DIVYA05GAVANE/3D_TFT/pdk/tft3d_platform/libs.ref/tft3d_macros/sim/FeTFT HSPICE/FeTFT_Netlist_IdVg_Polarity0.docx

Netlist: Polarity state = 0

DC sweep from -5V to +5V

* Generated for: HSPICE

* Generated on: Jul 3 17:10:52 2026

* Design library name: CAM_Circuits

* Design cell name: fetft_IdVg

* Design view name: schematic

.include '/apps/PDK/NCSU/FreePDK/FreePDK45/1.4/ncsu_basekit/models/hspice/hspice_nom.include'

* Library name: CAM_Circuits

* Cell name: fetft_IdVg

* View name: schematic

xi0 vg vd 0 fetft_nf1 pinit=0 vw=4

v1 vd 0 dc='Vd'

v2 vg 0 dc='Vg'

.param

+ Vg=0

+ Vd=100e-3

.temp 27.0

.option GEN_CUR_POL=ON

.option ARTIST=2 PSF=2 WARN_SEP=1

.option VECBUS=1 LIS_NEW=1 CONVERGE=100

.tran 100e-9 230e-6 start=0.0

.dc Vg -5.0 5.0 10e-3

.option hier_delim=1

.probe dc v(vg)

+ i(xi0.d)

.probe tran v(vg)

+ i(xi0.d)

.hdl "/users/grad/divyagavane/CAM_Circuits//fetft_nf1/veriloga/veriloga.va"

.end
