DIVYA05GAVANE/3D_TFT/3d_thermal_stress_sim/plots/stack_limit_summary.png

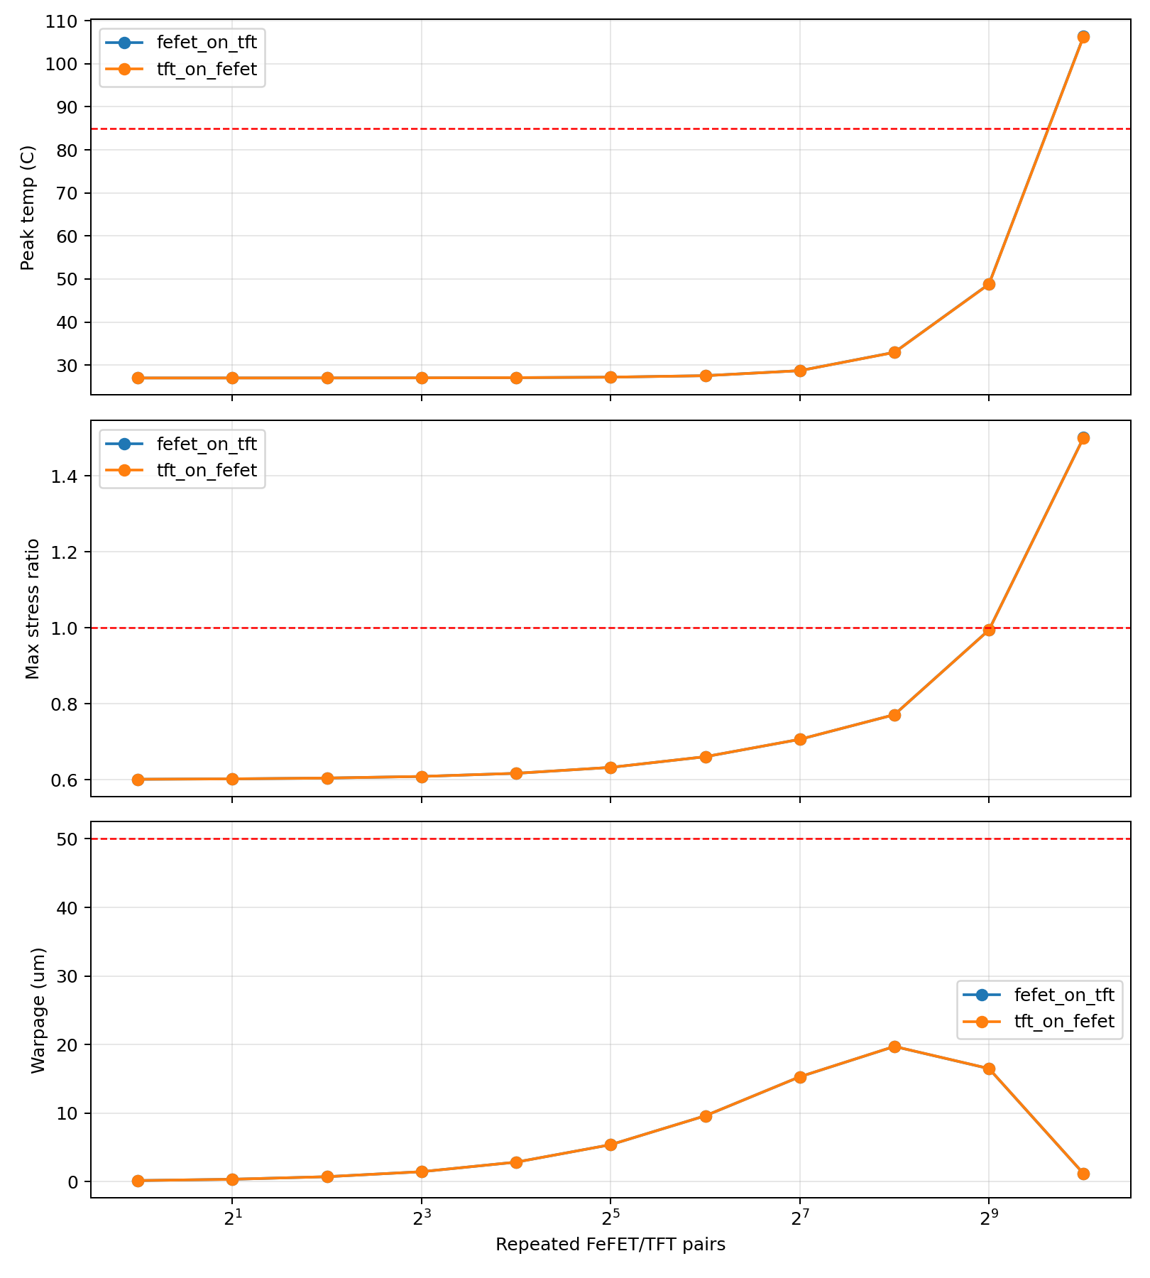
3d_thermal_stress_sim/plots/stack_limit_summary.png
