DIVYA05GAVANE/3D_TFT/pdk/tft3d_platform/libs.ref/tft3d_macros/sim/NG_spice_TFT/id_vds_tft_n1_ngspice.png

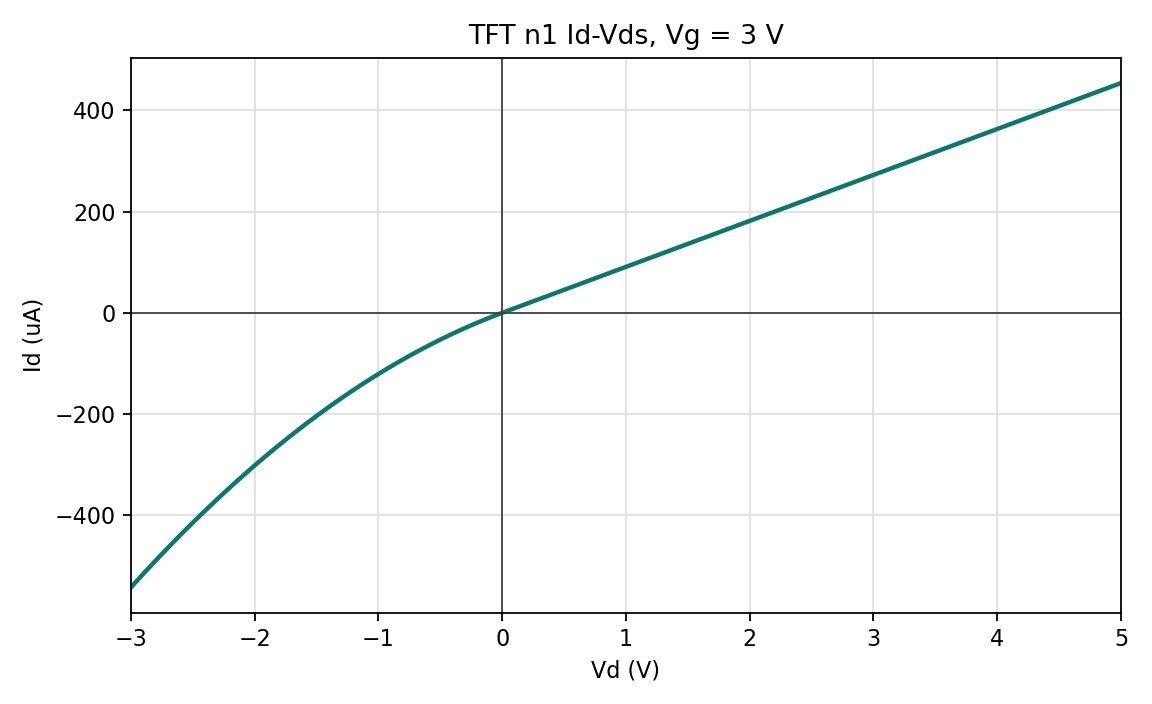
pdk/tft3d_platform/libs.ref/tft3d_macros/sim/NG_spice_TFT/id_vds_tft_n1_ngspice.png
