DIVYA05GAVANE/3D_TFT/tmp/pdfs/VLSI2026_01_20_v1_page_3.png

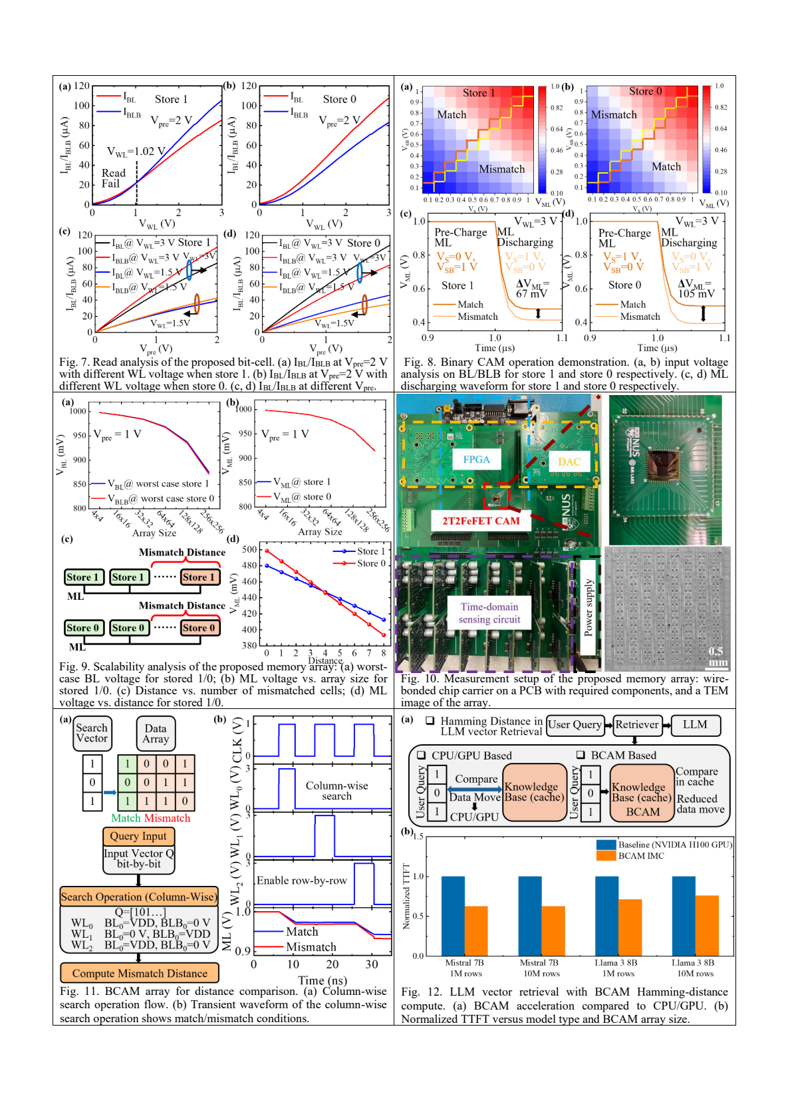
tmp/pdfs/VLSI2026_01_20_v1_page_3.png
