DIVYA05GAVANE/3D_TFT/pdk/tft3d_platform/libs.ref/tft3d_macros/sim/FeTFT HSPICE/FeTFT_IdVg_Curve.pdf

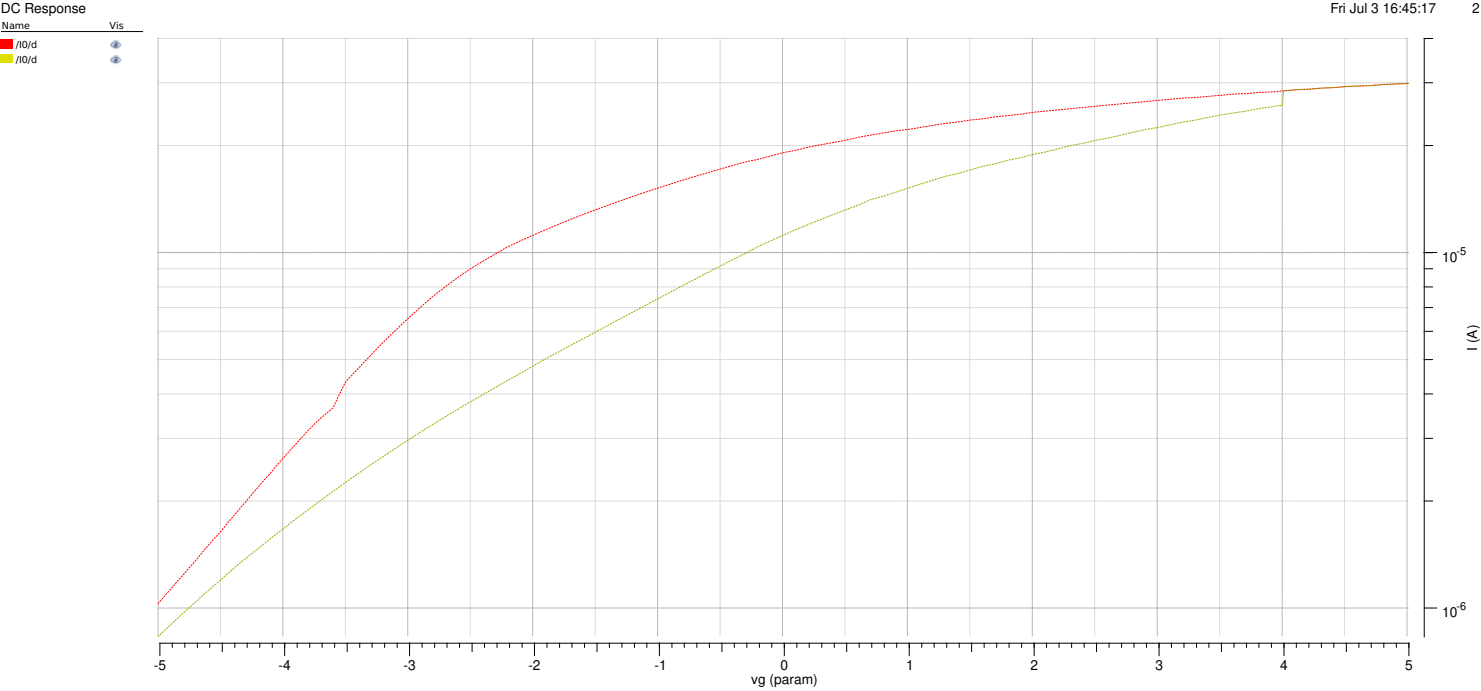
[picture p11: page 1]
Name; Vis; vg (param); DC Response; Fri Jul 3 16:45:17
