DIVYA05GAVANE/3D_TFT/pdk/tft3d_platform/libs.ref/tft3d_macros/sim/TFT HSPICE/Veriloga_gds_mapping.pdf

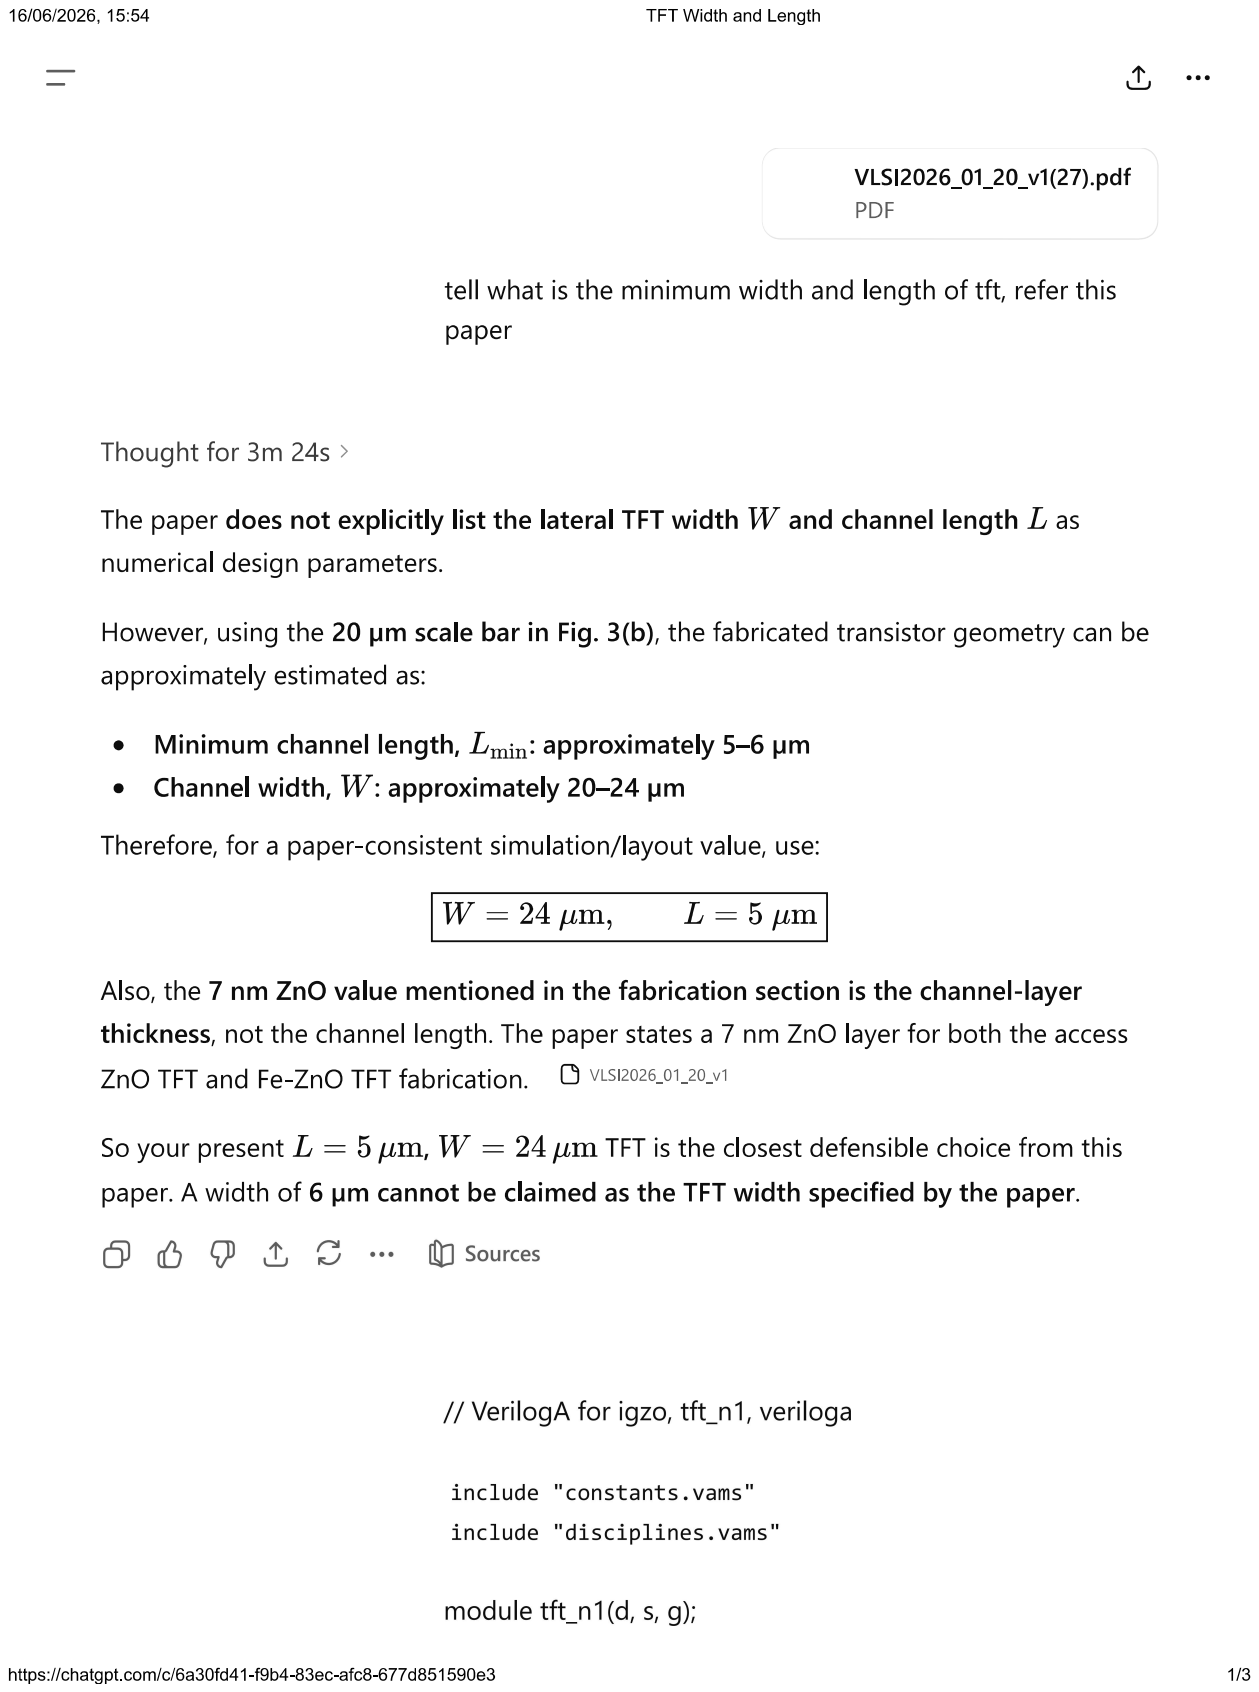
[picture p12: page 1]

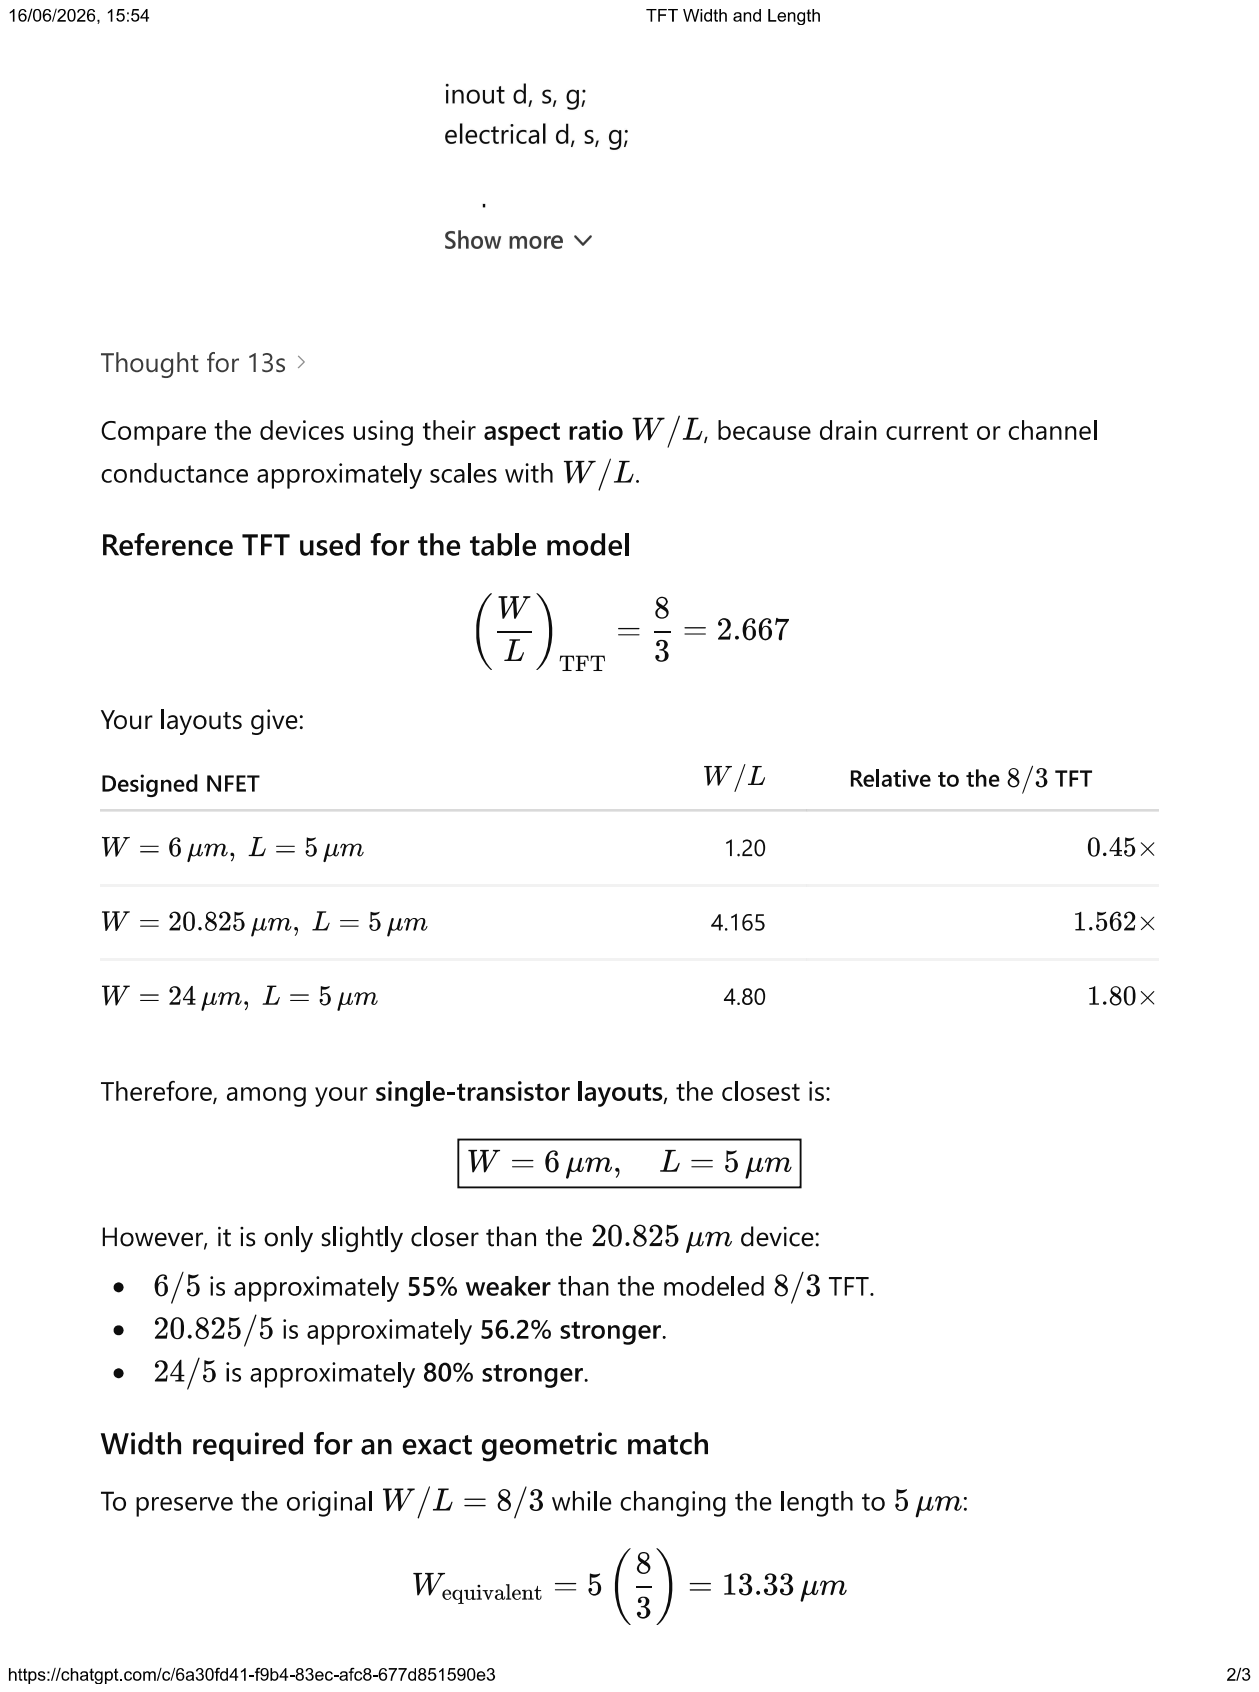
[picture p13: page 2]

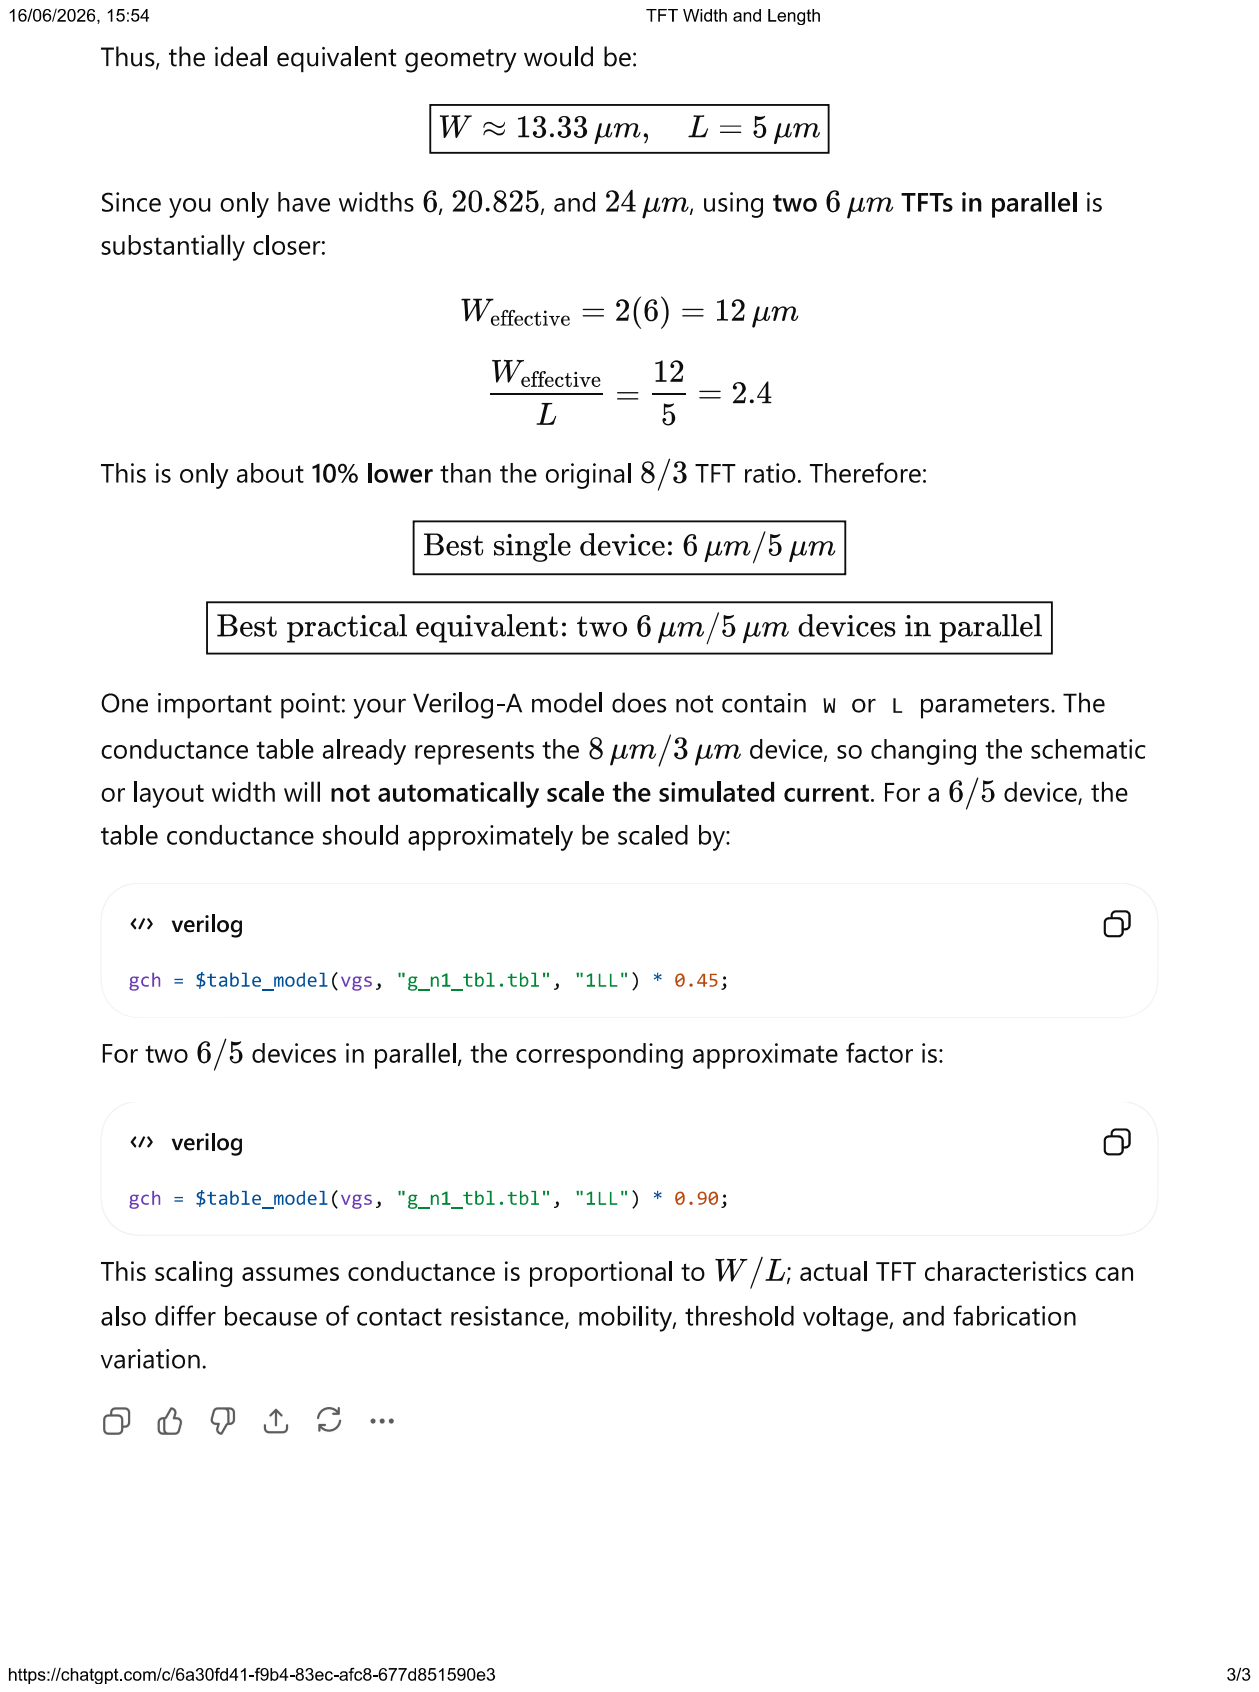
[picture p14: page 3]
