DIVYA05GAVANE/3D_TFT/open3dstack/verilog/open3dstack_user_defines.v

`ifndef OPEN3DSTACK_USER_DEFINES_V
`define OPEN3DSTACK_USER_DEFINES_V

`define OPEN3DSTACK_PAD_MODE_ANALOG  1'b0
`define OPEN3DSTACK_PAD_MODE_DIGITAL 1'b1

`ifndef OPEN3DSTACK_PAD_S00_MODE
`define OPEN3DSTACK_PAD_S00_MODE `OPEN3DSTACK_PAD_MODE_ANALOG
`endif
`ifndef OPEN3DSTACK_PAD_S01_MODE
`define OPEN3DSTACK_PAD_S01_MODE `OPEN3DSTACK_PAD_MODE_ANALOG
`endif
`ifndef OPEN3DSTACK_PAD_S02_MODE
`define OPEN3DSTACK_PAD_S02_MODE `OPEN3DSTACK_PAD_MODE_ANALOG
`endif
`ifndef OPEN3DSTACK_PAD_S03_MODE
`define OPEN3DSTACK_PAD_S03_MODE `OPEN3DSTACK_PAD_MODE_ANALOG
`endif
`ifndef OPEN3DSTACK_PAD_S04_MODE
`define OPEN3DSTACK_PAD_S04_MODE `OPEN3DSTACK_PAD_MODE_ANALOG
`endif
`ifndef OPEN3DSTACK_PAD_S05_MODE
`define OPEN3DSTACK_PAD_S05_MODE `OPEN3DSTACK_PAD_MODE_ANALOG
`endif
`ifndef OPEN3DSTACK_PAD_S06_MODE
`define OPEN3DSTACK_PAD_S06_MODE `OPEN3DSTACK_PAD_MODE_ANALOG
`endif
`ifndef OPEN3DSTACK_PAD_S07_MODE
`define OPEN3DSTACK_PAD_S07_MODE `OPEN3DSTACK_PAD_MODE_ANALOG
`endif
`ifndef OPEN3DSTACK_PAD_S08_MODE
`define OPEN3DSTACK_PAD_S08_MODE `OPEN3DSTACK_PAD_MODE_ANALOG
`endif
`ifndef OPEN3DSTACK_PAD_S09_MODE
`define OPEN3DSTACK_PAD_S09_MODE `OPEN3DSTACK_PAD_MODE_ANALOG
`endif
`ifndef OPEN3DSTACK_PAD_S10_MODE
`define OPEN3DSTACK_PAD_S10_MODE `OPEN3DSTACK_PAD_MODE_ANALOG
`endif
`ifndef OPEN3DSTACK_PAD_S11_MODE
`define OPEN3DSTACK_PAD_S11_MODE `OPEN3DSTACK_PAD_MODE_ANALOG
`endif
`ifndef OPEN3DSTACK_PAD_S12_MODE
`define OPEN3DSTACK_PAD_S12_MODE `OPEN3DSTACK_PAD_MODE_ANALOG
`endif
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
`define OPEN3DSTACK_PAD_W40_MODE `OPEN3DSTACK_PAD_MODE_ANALOG
`endif
`ifndef OPEN3DSTACK_PAD_W41_MODE
`define OPEN3DSTACK_PAD_W41_MODE `OPEN3DSTACK_PAD_MODE_ANALOG
`endif
`ifndef OPEN3DSTACK_PAD_W42_MODE
`define OPEN3DSTACK_PAD_W42_MODE `OPEN3DSTACK_PAD_MODE_ANALOG
`endif

`endif
