DIVYA05GAVANE/3D_TFT/(commit log)

2026-06-09 Added Pin labels and net names.
    Updated pin labels and net names for all three nfets, INV_X4PC, WL_prebuffer, WL_INV.
    WL_Sel is pending as layout needs to be updated.
2026-06-17 Uploaded netlist: Precharge Circuit
2026-06-18 update layout compactness for column driver and decoder
2026-06-18 Uploaded netlist for Full Peripheral Circuit
    Full integration of peripherals with array
2026-06-19 add parameterised model to TFT
    W and N vary based on base device measured with L=3um W=8um
2026-06-19 ngspice simulation for components made from TFT only
    nfet_w6u_l5 / nfet_w20p825_l5 / nfet_w24u_l5 Id-Vds
    nfet_w6u_l5 Id-Vg
    inv_x4pc_t5_nmos
    nand3_x4rl_t5
    wl_inv
    wl_prebuffer
    wl_sel
    wl_driver_nmos
    row_decoder_3to8_nmos
    column_decoder_3to8_nmos
    analog_mux_2to1_diff_nmos
    analog_mux_2to1_diff_nmos_schematic
    analog_mux_bl_sl_nmos
    precharge_equalizer_nmos_6u
    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
    [summary.csv]
2026-06-19 remove ngspice results for macro
    [summary.csv]
2026-06-20 Add 3D thermal stress simulation study
    [stack_limit_sweep.csv]
2026-06-24 Remapping waste layers
    Remapped the remaining folded test_fixture_NAND3_X4RL_T5 shapes/labels:layer 11 → 8
    layer 13 → 10
2026-06-24 DRC update
    TRACE_90_BEND_FULL_OVERLAP
2026-06-25 correct shorts below array
    vss driver wl and vwl n wl driver on padfreme to macro routes are getting overlapped with below sram array f5
2026-06-26 correct the wire/pad offsets
2026-06-27 update hierarchy for sel mux
    shift the sel mux new wires to padframe to macro routes
2026-06-27 update padframe to user wrapper route wire thickness
    Layer 8/0: 5.000 um
    Layer 9/0: 5.000 um
    Layer 10/0: 5.000 um
2026-06-28 Updated gds for write driver
    Re-designed layout of write driver from scratch, updated the gds with correct layer mapping.
2026-06-28 update test_fixture_master_slave_DFF hierarchy
    update DFF hierarchy for some 4 wires and also shift test fixtures a little top
2026-06-28 Write driver gds updated
    Updated labels in the new gds file of writ_driver_v2
2026-06-28 update write driver test fixture pad location
    left pads to reduce width
2026-06-28 update write driver test fixture pad location
    only update left side pads, not right
2026-06-28 update write driver v2 test fixture
2026-06-28 PR boundry for write driver v2
2026-06-29 update with write driver test structure
2026-07-01 Uploaded precharge circuit
    Completed layout design of precharge circuit and uploaded the same.
2026-07-03 Uploaded precharge circuit
    Cherry-picked-from: DIVYA05GAVANE/3D_TFT@2746d2b1b53ccf807d609572b568c7bd04305535
    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
2026-07-04 add precharge circuit
2026-07-04 Added write_driver_v3 GDS macro
    Re-designed layout for write driver and uploaded the same.
